David668668/rk3588naodian/最终底座.stl

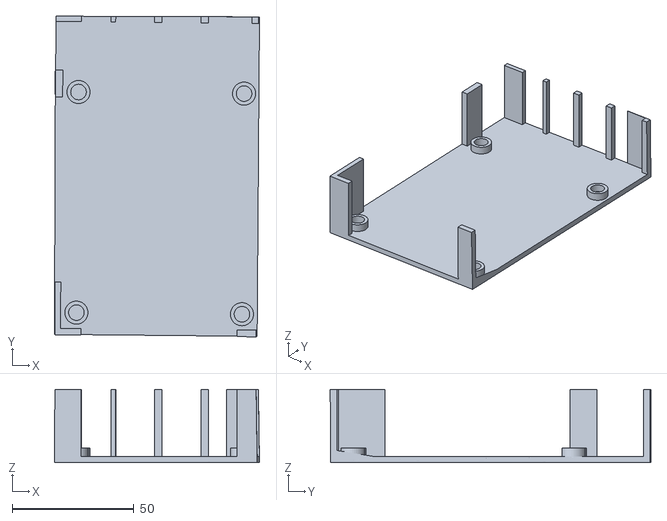
[picture p24: CAD file, 2026-07-09]
最终底座.stl
84.2 x 131.7 x 30.0
