David668668/rk3588naodian/脑环.stl

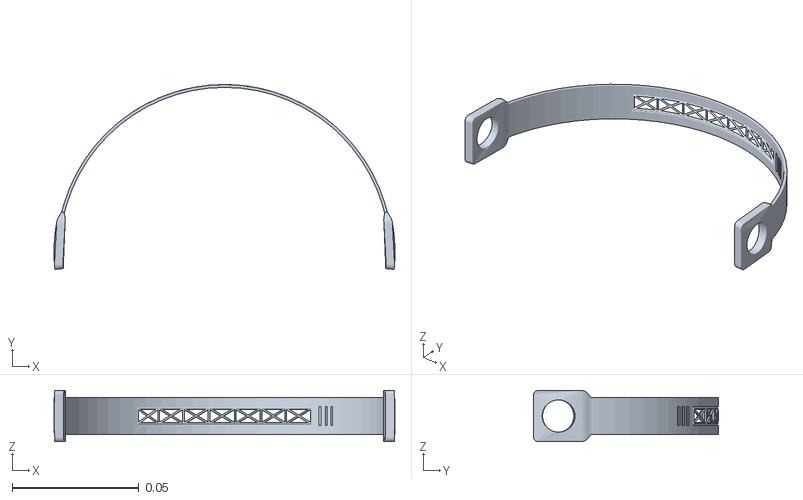
[picture p25: CAD file, 2026-07-09]
脑环.stl
0.135 x 0.073 x 0.0203
