David668668/rk3588naodian/最终顶.stl

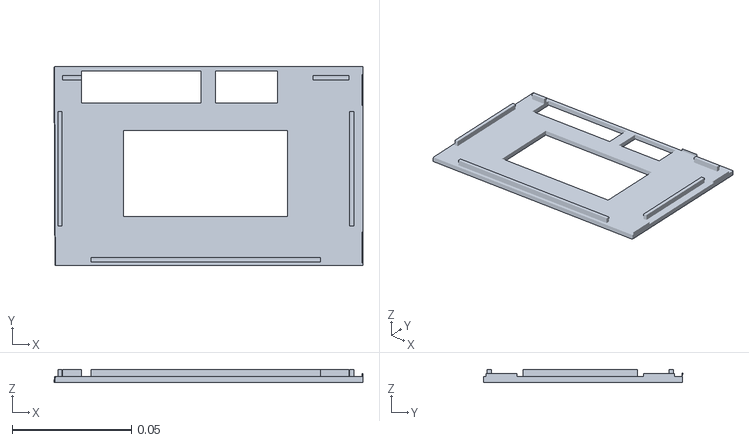
[picture p26: CAD file, 2026-07-09]
最终顶.stl
0.129 x 0.0834 x 0.0053
